Immortals-Robotics/ImmortalsMainPCB/README.md

# Immortals Main Electronics
The main electronics of Immortals SSL robots, used to receive commands from the main computer through wireless link, drive the robots’ motors, apply a control loop on the motors, do some local sensing and send some feedback data to the main computer.
