Immortals-Robotics/ImmortalsMainPCB/compute-module.kicad_sch

## KiCad design compute-module.kicad_sch (2024-02-27)

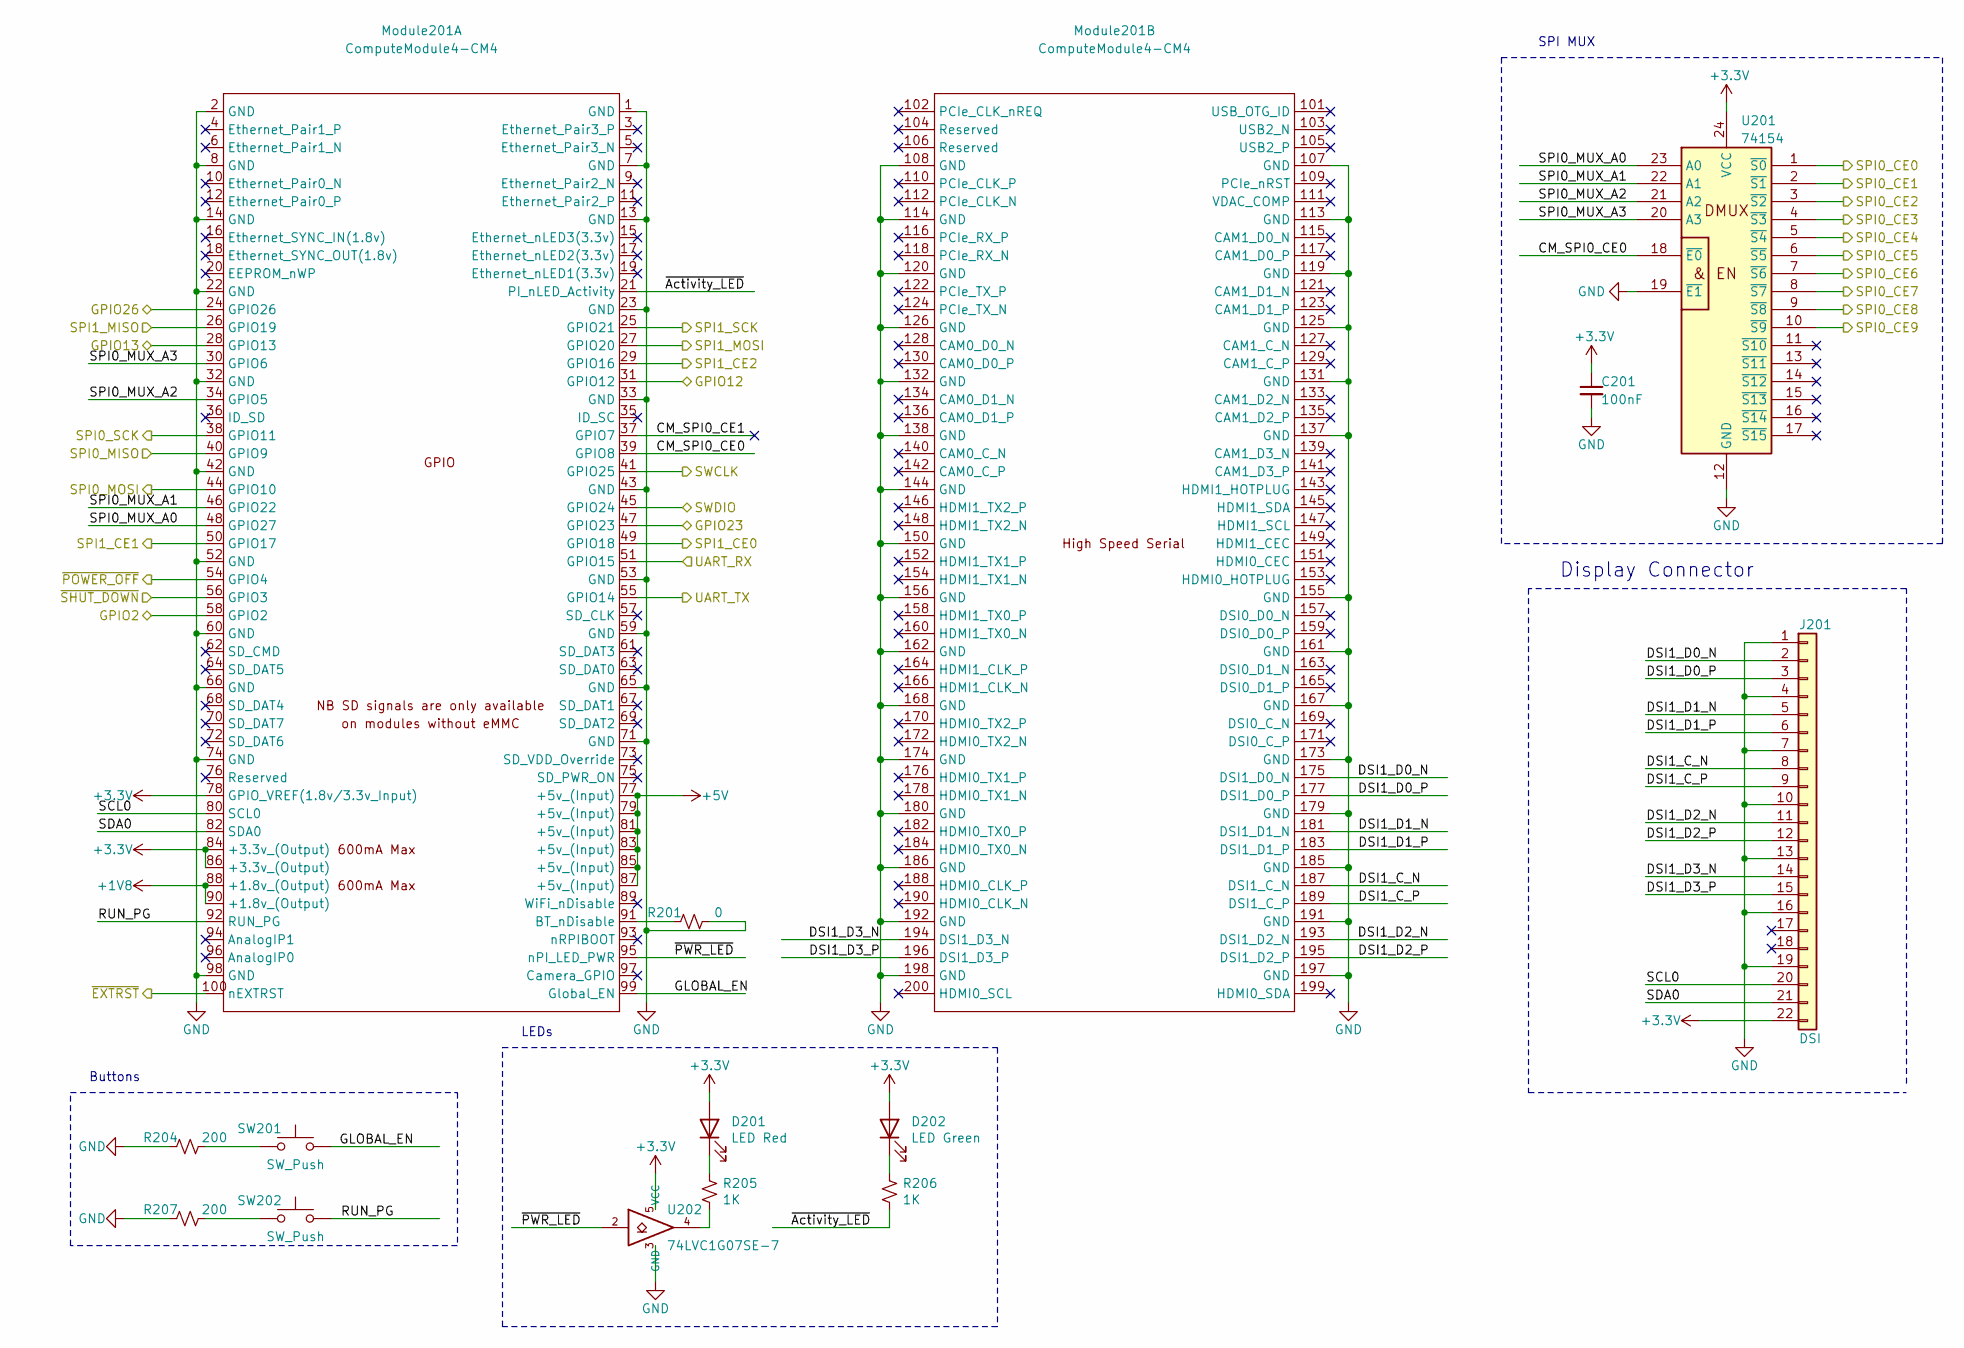
[picture p1: schematic compute-module.kicad_sch]

Parts:
C201: 100nF; C_0603_1608Metric; MPN C0603C104K4RAC7081
D201: LED Red; LED_0603_1608Metric; MPN B1911USD-20D000114U1930
D202: LED Green; LED_0603_1608Metric; MPN B1911PG--20D000514U1930
J201: DSI; Hirose_FH12-22S-0.5SH_1x22-1MP_P0.50mm_Horizontal; MPN FH12-22S-0.5SH55
Module201: ComputeModule4-CM4; rpi-cm4; MPN 2x DF40C-100DS-0.4V(51)
R201: 0; R_0603_1608Metric; MPN RMCF0603ZT0R00
R204, R207: 200; R_0603_1608Metric; MPN RC0603FR-13200RL
R205, R206: 1K; R_0603_1608Metric; MPN RC0603FR-101KL
SW201, SW202: SW_Push; SW_SPST_B3U-1000P; MPN B3U-1000P
U201: 74154; DHVQFN24; MPN 74HCT154BQ,118
U202: 74LVC1G07SE-7; SOT-353_SC-70-5; MPN 74LVC1G07SE-7

Connections:
+1V8: Module201.88 (+1.8v_(Output)), Module201.90 (+1.8v_(Output))
+3.3V: C201.1, D201.2 (A), D202.2 (A), J201.22, Module201.78 (GPIO_VREF(1.8v/3.3v_Input)), Module201.84 (+3.3v_(Output)), Module201.86 (+3.3v_(Output)), U201.24 (VCC), U202.5 (VCC)
+5V: Module201.77 (+5v_(Input)), Module201.79 (+5v_(Input)), Module201.81 (+5v_(Input)), Module201.83 (+5v_(Input)), Module201.85 (+5v_(Input)), Module201.87 (+5v_(Input))
CM_SPI0_CE0: Module201.39 (GPIO8), U201.18 (~E0)
CM_SPI0_CE1: Module201.37 (GPIO7)
DSI1_C_N: J201.8, Module201.187 (DSI1_C_N)
DSI1_C_P: J201.9, Module201.189 (DSI1_C_P)
DSI1_D0_N: J201.2, Module201.175 (DSI1_D0_N)
DSI1_D0_P: J201.3, Module201.177 (DSI1_D0_P)
DSI1_D1_N: J201.5, Module201.181 (DSI1_D1_N)
DSI1_D1_P: J201.6, Module201.183 (DSI1_D1_P)
DSI1_D2_N: J201.11, Module201.193 (DSI1_D2_N)
DSI1_D2_P: J201.12, Module201.195 (DSI1_D2_P)
GLOBAL_EN: Module201.99 (Global_EN), SW201.2
GND: C201.2, J201.1, J201.4, J201.7, J201.10, J201.13, J201.14, J201.15, J201.16, J201.19, Module201.1 (GND), Module201.2 (GND), Module201.7 (GND), Module201.8 (GND), Module201.13 (GND), Module201.14 (GND), Module201.22 (GND), Module201.23 (GND), Module201.32 (GND), Module201.33 (GND), Module201.42 (GND), Module201.43 (GND), Module201.52 (GND), Module201.53 (GND), Module201.59 (GND), Module201.60 (GND), Module201.65 (GND), Module201.66 (GND), Module201.71 (GND), Module201.74 (GND), Module201.98 (GND), Module201.107 (GND), Module201.108 (GND), Module201.113 (GND), Module201.114 (GND), Module201.119 (GND), Module201.120 (GND), Module201.125 (GND), Module201.126 (GND), Module201.131 (GND), Module201.132 (GND), Module201.137 (GND), Module201.138 (GND), Module201.144 (GND), Module201.150 (GND), Module201.155 (GND), Module201.156 (GND), Module201.161 (GND), Module201.162 (GND), Module201.167 (GND), Module201.168 (GND), Module201.173 (GND), Module201.174 (GND), Module201.179 (GND), Module201.180 (GND), Module201.185 (GND), Module201.186 (GND), Module201.191 (GND), Module201.192 (GND), Module201.194 (DSI1_D3_N), Module201.196 (DSI1_D3_P), Module201.197 (GND), Module201.198 (GND), R201.2, R204.1, R207.1, U201.12 (GND), U201.19 (~E1), U202.3 (GND)
GPIO2: Module201.58 (GPIO2)
GPIO12: Module201.31 (GPIO12)
GPIO13: Module201.28 (GPIO13)
GPIO23: Module201.47 (GPIO23)
GPIO26: Module201.24 (GPIO26)
unnamed: D201.1 (K), R205.1
unnamed: D202.1 (K), R206.1
unnamed: Module201.91 (BT_nDisable), R201.1
unnamed: R204.2, SW201.1
unnamed: R205.2, U202.4
unnamed: R207.2, SW202.1
RUN_PG: Module201.92 (RUN_PG), SW202.2
SCL0: J201.20, Module201.80 (SCL0)
SDA0: J201.21, Module201.82 (SDA0)
SPI0_CE0: U201.1 (~S0)
SPI0_CE1: U201.2 (~S1)
SPI0_CE2: U201.3 (~S2)
SPI0_CE3: U201.4 (~S3)
SPI0_CE4: U201.5 (~S4)
SPI0_CE5: U201.6 (~S5)
SPI0_CE6: U201.7 (~S6)
SPI0_CE7: U201.8 (~S7)
SPI0_CE8: U201.9 (~S8)
SPI0_CE9: U201.10 (~S9)
SPI0_MISO: Module201.40 (GPIO9)
SPI0_MOSI: Module201.44 (GPIO10)
SPI0_MUX_A0: Module201.48 (GPIO27), U201.23 (A0)
SPI0_MUX_A1: Module201.46 (GPIO22), U201.22 (A1)
SPI0_MUX_A2: Module201.34 (GPIO5), U201.21 (A2)
SPI0_MUX_A3: Module201.30 (GPIO6), U201.20 (A3)
SPI0_SCK: Module201.38 (GPIO11)
SPI1_CE0: Module201.49 (GPIO18)
SPI1_CE1: Module201.50 (GPIO17)
SPI1_CE2: Module201.29 (GPIO16)
SPI1_MISO: Module201.26 (GPIO19)
SPI1_MOSI: Module201.27 (GPIO20)
SPI1_SCK: Module201.25 (GPIO21)
SWCLK: Module201.41 (GPIO25)
SWDIO: Module201.45 (GPIO24)
UART_RX: Module201.51 (GPIO15)
UART_TX: Module201.55 (GPIO14)
~Activity_LED: Module201.21 (PI_nLED_Activity), R206.2
~EXTRST: Module201.100 (nEXTRST)
~POWER_OFF: Module201.54 (GPIO4)
~PWR_LED: Module201.95 (nPI_LED_PWR), U202.2
~SHUT_DOWN: Module201.56 (GPIO3)

Notes on the sheet:
Display Connector
SPI MUX
Buttons
LEDs
