Immortals-Robotics/ImmortalsMainPCB/main-board.kicad_sch

## KiCad design main-board.kicad_sch (2024-02-27)

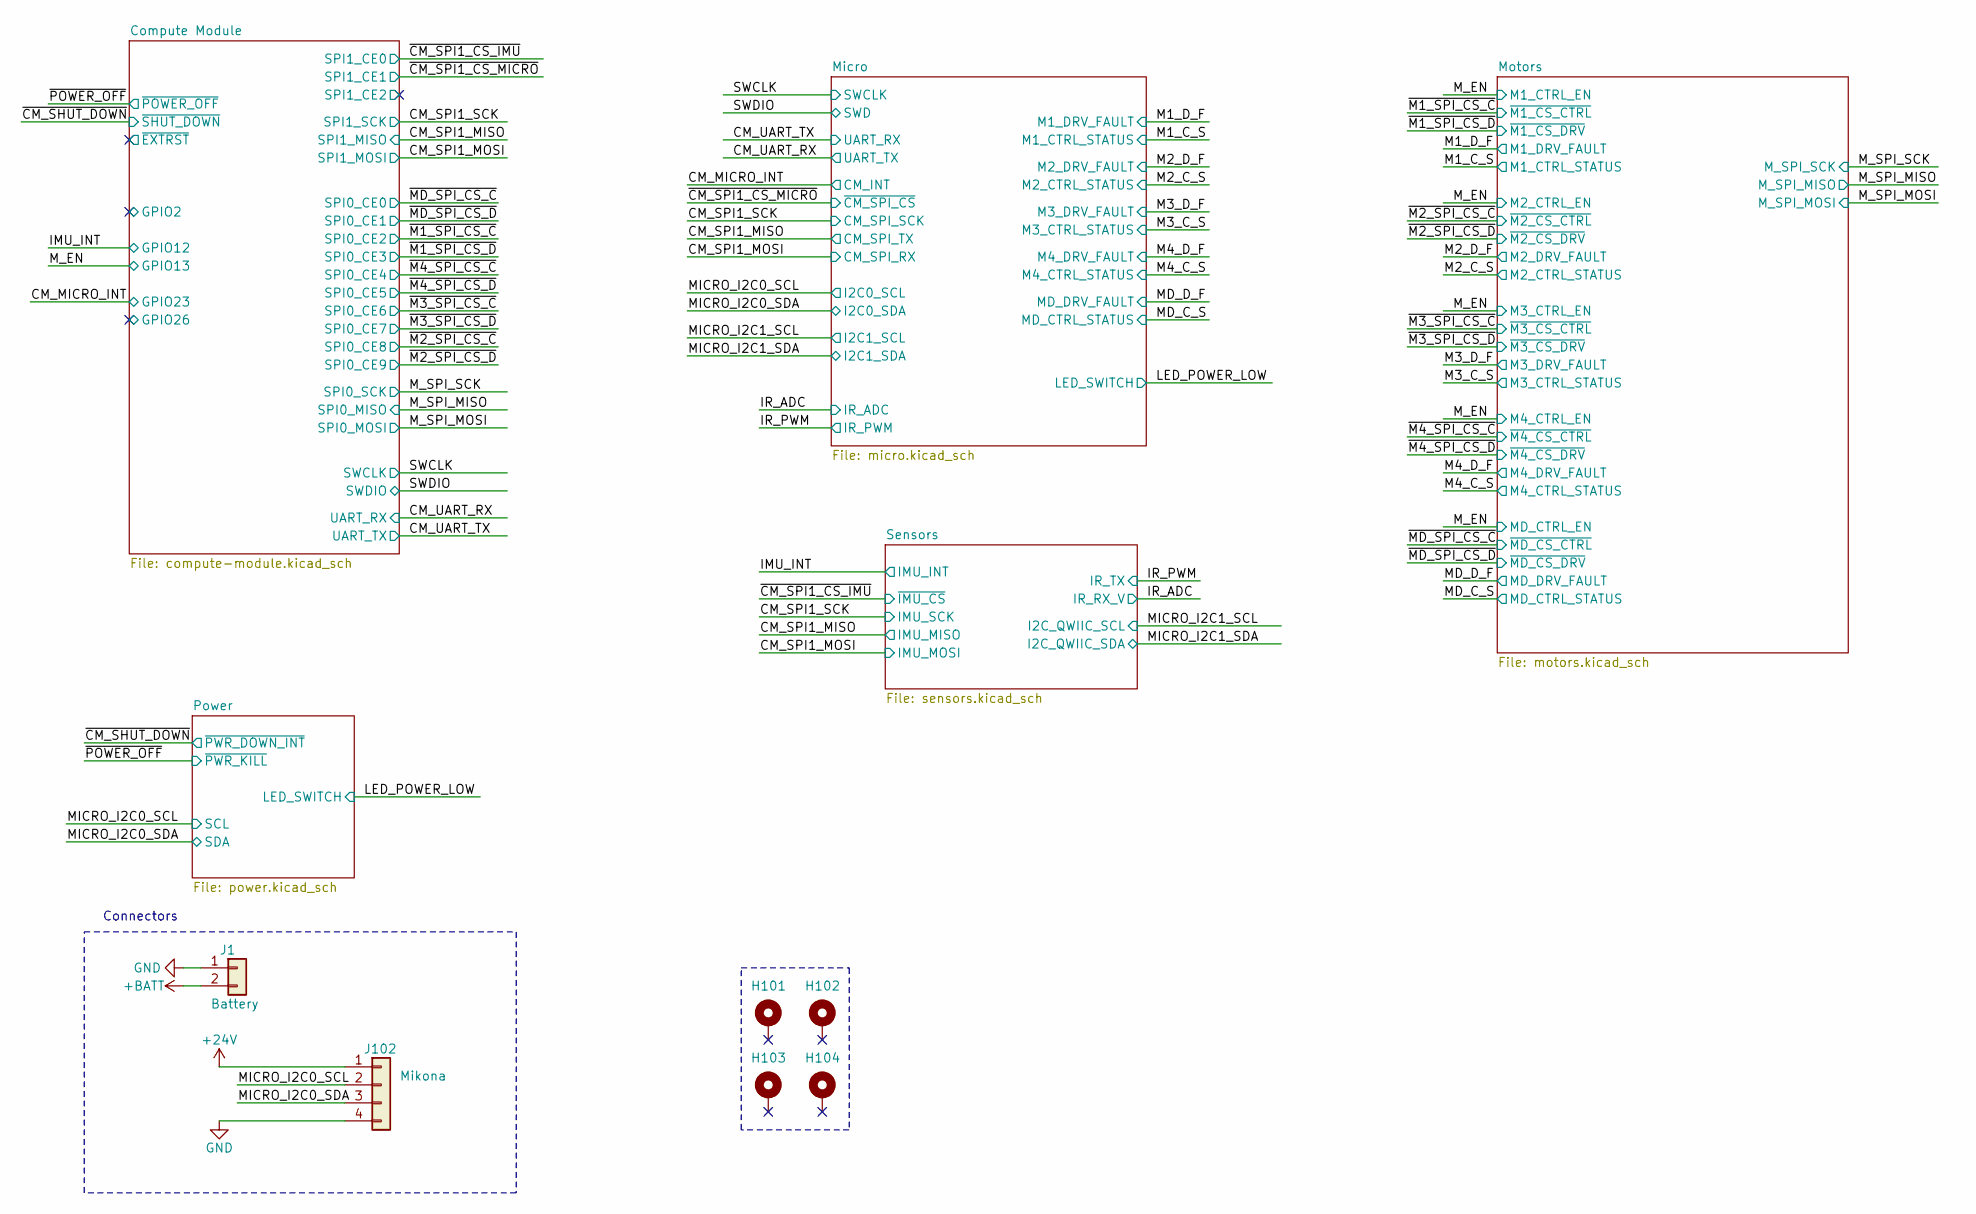
[picture p2: schematic main-board.kicad_sch]

Parts:
H101, H102, H103, H104: MountingHole_Pad; MountingHole_3.2mm_M3_ISO14580_Pad
J1: Battery; AMASS_XT60PW-M_1x02_P7.20mm_Horizontal; MPN XT60PW-M
J102: Mikona; MOLEX_1054301204; MPN 1054301204

Connections:
+24V: J102.1
+BATT: J1.2
GND: J1.1, J102.4
MICRO_I2C0_SCL: J102.2
MICRO_I2C0_SDA: J102.3

Notes on the sheet:
Connectors
