Immortals-Robotics/ImmortalsMainPCB/micro.kicad_sch

## KiCad design micro.kicad_sch (2024-02-27)

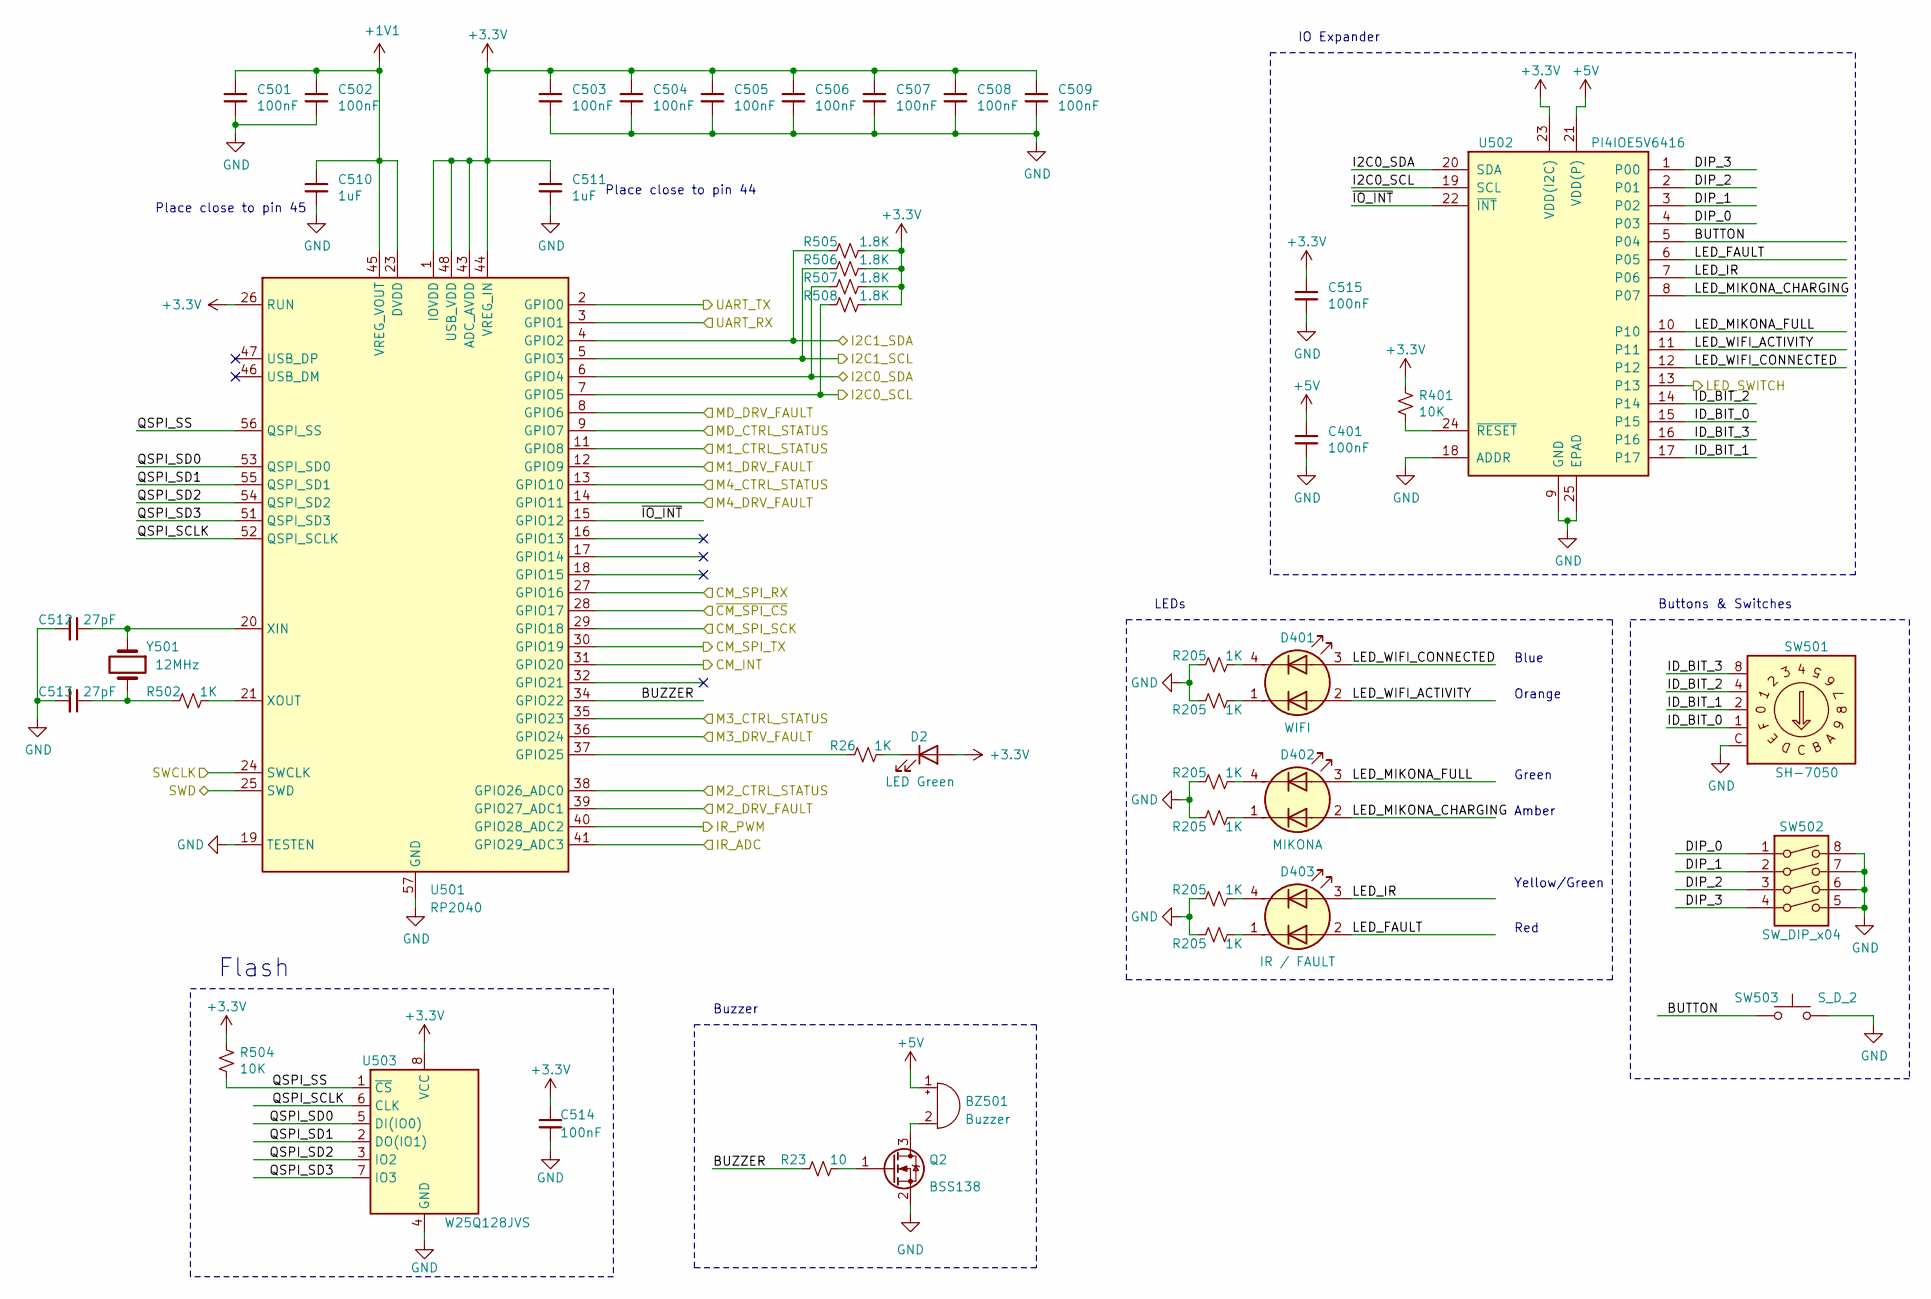
[picture p3: schematic micro.kicad_sch]

Parts:
BZ501: Buzzer; Indicator_PUI_AI-1440-TWT-24V-2-R; MPN CPI-137-83T
C401, C501, C502, C503, C504, C505, C506, C507, C508, C509, C514, C515: 100nF; C_0603_1608Metric; MPN C0603C104K4RAC7081
C510, C511: 1uF; C_0603_1608Metric; MPN C0603C105K4RAC7411
C512, C513: 27pF; C_0603_1608Metric; MPN 06035C270JAT2A
D2: LED Green; LED_0603_1608Metric; MPN B1911PG--20D000514U1930
D401: WIFI; B2612U; MPN B2612UDNB20D000312U1930
D402: MIKONA; B2612U; MPN B2612UYNG20D000412U1930
D403: IR / FAULT; B2612U; MPN B2612USUG20D000312U1930
Q2: BSS138; SOT-23; MPN BSS138-7-F
R23: 10; R_0603_1608Metric; MPN RC0603FR-1010RL
R26, R205, R502: 1K; R_0603_1608Metric; MPN RC0603FR-101KL
R401, R504: 10K; R_0603_1608Metric; MPN RC0603JR-1010KL
R505, R506, R507, R508: 1.8K; R_0603_1608Metric; MPN RC0603FR-101K8L
SW501: SH-7050; Nidec_Copal_SH-7010A; MPN SH-7050TA
SW502: SW_DIP_x04; SW_DIP_SPSTx04_Slide_6.7x11.72mm_W8.61mm_P2.54mm_LowProfile; MPN 219-4MST
SW503: S_D_2; SW_Push_1P1T_NO_6x6mm_H9.5mm; MPN PTS645SL43SMTR92 LFS
U501: RP2040; QFN-56-1EP_7x7mm_P0.4mm_EP3.2x3.2mm; MPN SC0914(13)
U502: PI4IOE5V6416; WQFN-24-1EP_4x4mm_P0.5mm_EP2.45x2.45mm; MPN PI4IOE5V6416ZDEX
U503: W25Q128JVS; SOIC-8_5.23x5.23mm_P1.27mm; MPN W25Q128JVSIQ
Y501: 12MHz; Crystal_SMD_5032-2Pin_5.0x3.2mm; MPN 445C25D12M00000

Connections:
+1V1: C501.1, C502.1, C510.1, U501.23 (DVDD), U501.45 (VREG_VOUT), U501.50 (DVDD)
+3.3V: C503.1, C504.1, C505.1, C506.1, C507.1, C508.1, C509.1, C511.1, C514.1, C515.1, D2.2 (A), R401.1, R504.1, R505.1, R506.1, R507.1, R508.1, U501.1 (IOVDD), U501.10 (IOVDD), U501.22 (IOVDD), U501.26 (RUN), U501.33 (IOVDD), U501.42 (IOVDD), U501.43 (ADC_AVDD), U501.44 (VREG_IN), U501.48 (USB_VDD), U501.49 (IOVDD), U502.23 (VDD(I2C)), U503.8 (VCC)
+5V: BZ501.1 (-), C401.1, U502.21 (VDD(P))
BUTTON: SW503.1, U502.5 (P04)
BUZZER: R23.1, U501.34 (GPIO22)
CM_INT: U501.31 (GPIO20)
CM_SPI_RX: U501.27 (GPIO16)
CM_SPI_SCK: U501.29 (GPIO18)
CM_SPI_TX: U501.30 (GPIO19)
DIP_0: SW502.1, U502.4 (P03)
DIP_1: SW502.2, U502.3 (P02)
DIP_2: SW502.3, U502.2 (P01)
DIP_3: SW502.4, U502.1 (P00)
GND: C401.2, C501.2, C502.2, C503.2, C504.2, C505.2, C506.2, C507.2, C508.2, C509.2, C510.2, C511.2, C512.2, C513.2, C514.2, C515.2, Q2.2 (S), R205.1, SW501.C, SW502.5, SW502.6, SW502.7, SW502.8, SW503.2, U501.19 (TESTEN), U501.57 (GND), U502.9 (GND), U502.18 (ADDR), U502.25 (EPAD), U503.4 (GND)
I2C0_SCL: R508.2, U501.7 (GPIO5), U502.19 (SCL)
I2C0_SDA: R507.2, U501.6 (GPIO4), U502.20 (SDA)
I2C1_SCL: R506.2, U501.5 (GPIO3)
I2C1_SDA: R505.2, U501.4 (GPIO2)
ID_BIT_0: SW501.1, U502.15
ID_BIT_1: SW501.2, U502.17
ID_BIT_2: SW501.4, U502.14
ID_BIT_3: SW501.8, U502.16
IR_ADC: U501.41 (GPIO29_ADC3)
IR_PWM: U501.40 (GPIO28_ADC2)
LED_FAULT: D403.2 (A1), U502.6 (P05)
LED_IR: D403.3 (A2), U502.7 (P06)
LED_MIKONA_CHARGING: D402.2 (A1), U502.8 (P07)
LED_MIKONA_FULL: D402.3 (A2), U502.10
LED_SWITCH: U502.13
LED_WIFI_ACTIVITY: D401.2 (A1), U502.11
LED_WIFI_CONNECTED: D401.3 (A2), U502.12
M1_CTRL_STATUS: U501.11 (GPIO8)
M1_DRV_FAULT: U501.12 (GPIO9)
M2_CTRL_STATUS: U501.38 (GPIO26_ADC0)
M2_DRV_FAULT: U501.39 (GPIO27_ADC1)
M3_CTRL_STATUS: U501.35 (GPIO23)
M3_DRV_FAULT: U501.36 (GPIO24)
M4_CTRL_STATUS: U501.13 (GPIO10)
M4_DRV_FAULT: U501.14 (GPIO11)
MD_CTRL_STATUS: U501.9 (GPIO7)
MD_DRV_FAULT: U501.8 (GPIO6)
unnamed: BZ501.2 (+), Q2.3 (D)
unnamed: C512.1, U501.20 (XIN), Y501.1
unnamed: C513.1, R502.2, Y501.2
unnamed: D2.1 (K), R26.2
unnamed: D401.1 (K1), R205.2
unnamed: D401.4 (K2), R205.2
unnamed: D402.1 (K1), R205.2
unnamed: D402.4 (K2), R205.2
unnamed: D403.1 (K1), R205.2
unnamed: D403.4 (K2), R205.2
unnamed: Q2.1 (G), R23.2
unnamed: R26.1, U501.37 (GPIO25)
unnamed: R401.2, U502.24 (~RESET)
unnamed: R502.1, U501.21 (XOUT)
QSPI_SCLK: U501.52 (QSPI_SCLK), U503.6 (CLK)
QSPI_SD0: U501.53 (QSPI_SD0), U503.5 (DI(IO0))
QSPI_SD1: U501.55 (QSPI_SD1), U503.2 (DO(IO1))
QSPI_SD2: U501.54 (QSPI_SD2), U503.3 (IO2)
QSPI_SD3: U501.51 (QSPI_SD3), U503.7 (IO3)
QSPI_SS: R504.2, U501.56 (QSPI_SS), U503.1 (~CS)
SWCLK: U501.24 (SWCLK)
SWD: U501.25 (SWD)
UART_RX: U501.3 (GPIO1)
UART_TX: U501.2 (GPIO0)
~CM_SPI_CS: U501.28 (GPIO17)
~IO_INT: U501.15 (GPIO12), U502.22 (~INT)

Notes on the sheet:
Place close to pin 44
Flash
Place close to pin 45
Red
LEDs
Orange
IO Expander
Green
Buttons & Switches
Amber
Buzzer
Yellow/Green
Blue
