Immortals-Robotics/ImmortalsMainPCB/motors.kicad_sch

## KiCad design motors.kicad_sch (2024-02-27)

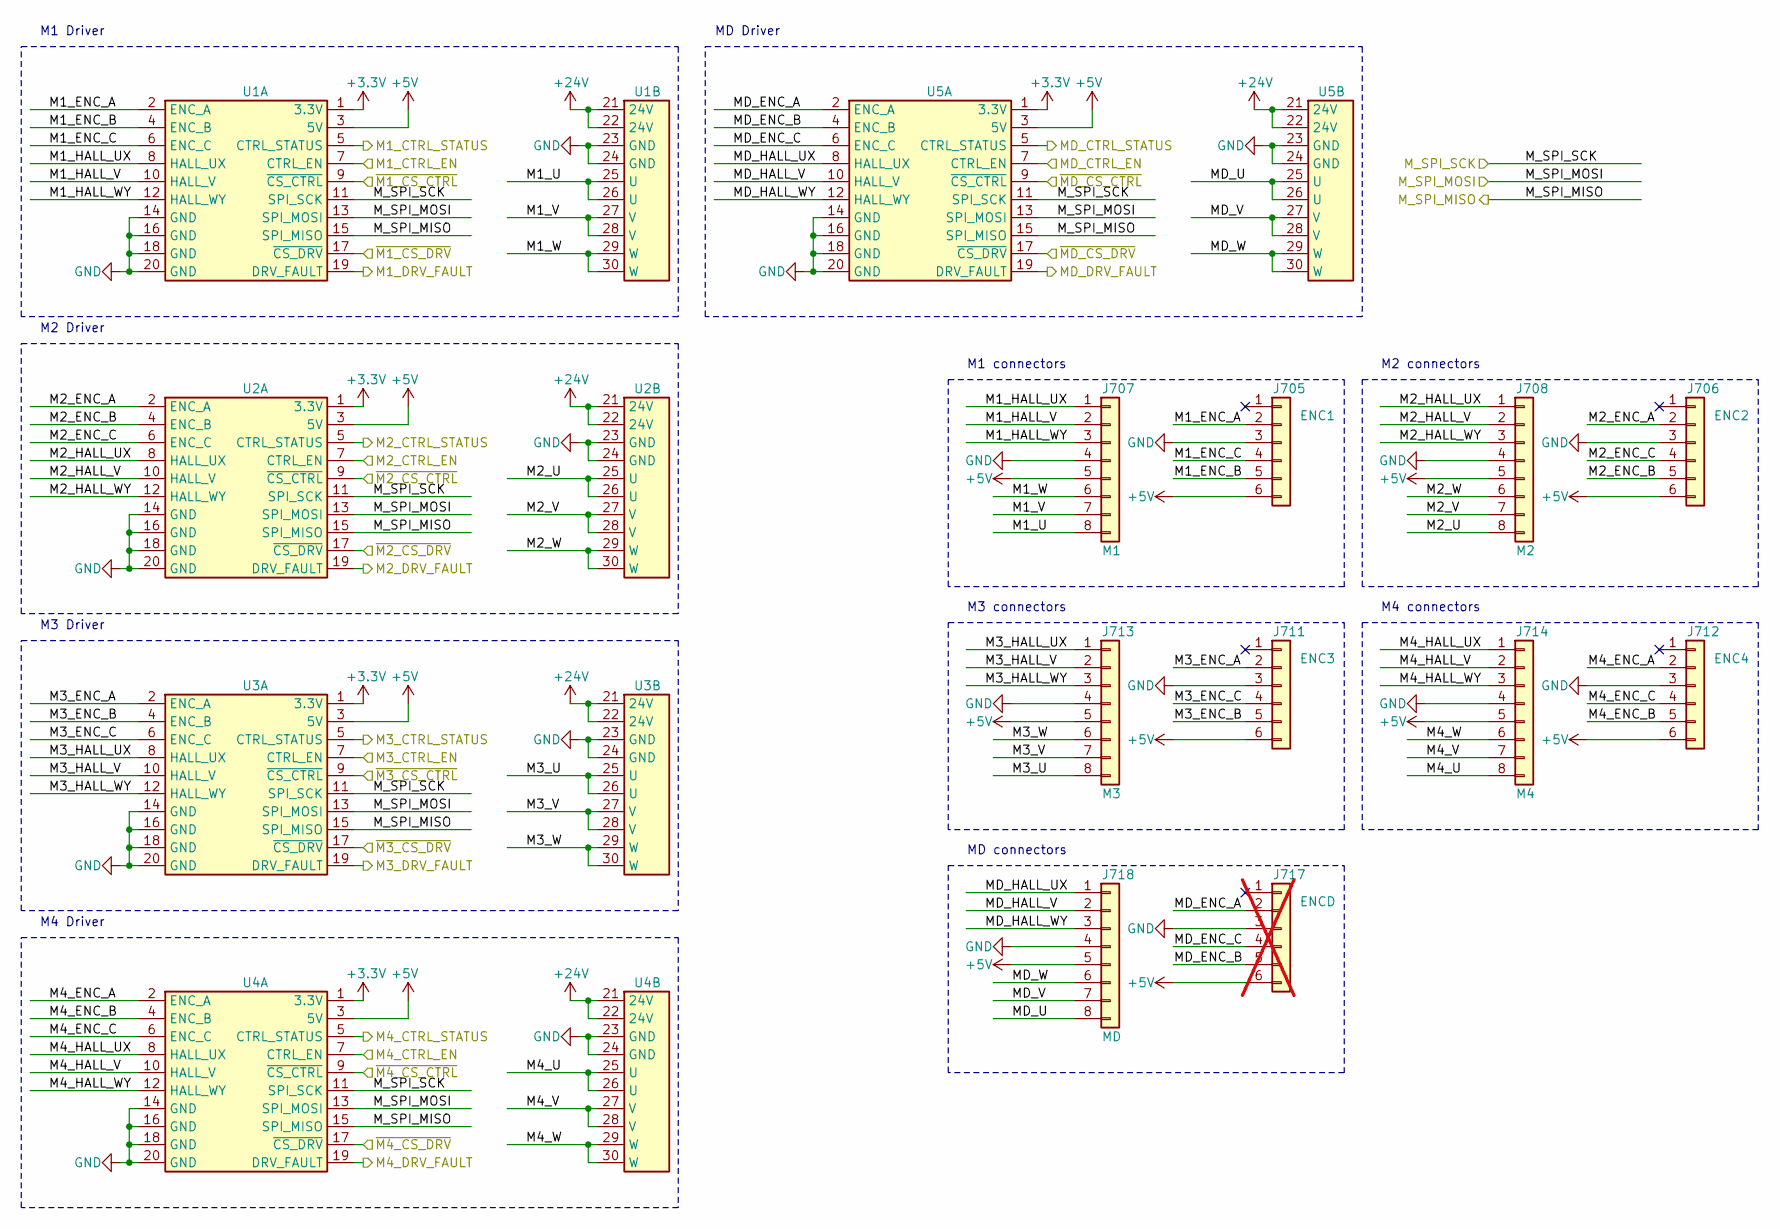
[picture p4: schematic motors.kicad_sch]

Parts:
J705: ENC1; Molex_PicoBlade_53261-0671_1x06-1MP_P1.25mm_Horizontal; MPN 0532610671
J706: ENC2; Molex_PicoBlade_53261-0671_1x06-1MP_P1.25mm_Horizontal; MPN 0532610671
J707: M1; JST_XH_S8B-XH-A_1x08_P2.50mm_Horizontal; MPN S8B-XH-A(LF)(SN)
J708: M2; JST_XH_S8B-XH-A_1x08_P2.50mm_Horizontal; MPN S8B-XH-A(LF)(SN)
J711: ENC3; Molex_PicoBlade_53261-0671_1x06-1MP_P1.25mm_Horizontal; MPN 0532610671
J712: ENC4; Molex_PicoBlade_53261-0671_1x06-1MP_P1.25mm_Horizontal; MPN 0532610671
J713: M3; JST_XH_S8B-XH-A_1x08_P2.50mm_Horizontal; MPN S8B-XH-A(LF)(SN)
J714: M4; JST_XH_S8B-XH-A_1x08_P2.50mm_Horizontal; MPN S8B-XH-A(LF)(SN)
J717: ENCD; Molex_PicoBlade_53261-0671_1x06-1MP_P1.25mm_Horizontal; MPN 0532610671; not fitted
J718: MD; JST_XH_S8B-XH-A_1x08_P2.50mm_Horizontal; MPN S8B-XH-A(LF)(SN)
U1, U2, U3, U4, U5: MotorDriver-SMT; MPN 61032021821 + NPPC101KFXC-RC

Connections:
+3.3V: U1.1 (3.3V), U2.1 (3.3V), U3.1 (3.3V), U4.1 (3.3V), U5.1 (3.3V)
+5V: J705.6, J706.6, J707.5, J708.5, J711.6, J712.6, J713.5, J714.5, J717.6, J718.5, U1.3 (5V), U2.3 (5V), U3.3 (5V), U4.3 (5V), U5.3 (5V)
+24V: U1.21 (24V), U1.22 (24V), U2.21 (24V), U2.22 (24V), U3.21 (24V), U3.22 (24V), U4.21 (24V), U4.22 (24V), U5.21 (24V), U5.22 (24V)
GND: J705.3, J706.3, J707.4, J708.4, J711.3, J712.3, J713.4, J714.4, J717.3, J718.4, U1.14 (GND), U1.16 (GND), U1.18 (GND), U1.20 (GND), U1.23 (GND), U1.24 (GND), U2.14 (GND), U2.16 (GND), U2.18 (GND), U2.20 (GND), U2.23 (GND), U2.24 (GND), U3.14 (GND), U3.16 (GND), U3.18 (GND), U3.20 (GND), U3.23 (GND), U3.24 (GND), U4.14 (GND), U4.16 (GND), U4.18 (GND), U4.20 (GND), U4.23 (GND), U4.24 (GND), U5.14 (GND), U5.16 (GND), U5.18 (GND), U5.20 (GND), U5.23 (GND), U5.24 (GND)
M1_CTRL_EN: U1.7 (CTRL_EN)
M1_CTRL_STATUS: U1.5 (CTRL_STATUS)
M1_DRV_FAULT: U1.19 (DRV_FAULT)
M1_ENC_A: J705.2, U1.2 (ENC_A)
M1_ENC_B: J705.5, U1.4 (ENC_B)
M1_ENC_C: J705.4, U1.6 (ENC_C)
M1_HALL_UX: J707.1, U1.8 (HALL_UX)
M1_HALL_V: J707.2, U1.10 (HALL_V)
M1_HALL_WY: J707.3, U1.12 (HALL_WY)
M1_U: J707.8, U1.25 (U), U1.26 (U)
M1_V: J707.7, U1.27 (V), U1.28 (V)
M1_W: J707.6, U1.29 (W), U1.30 (W)
M2_CTRL_EN: U2.7 (CTRL_EN)
M2_CTRL_STATUS: U2.5 (CTRL_STATUS)
M2_DRV_FAULT: U2.19 (DRV_FAULT)
M2_ENC_A: J706.2, U2.2 (ENC_A)
M2_ENC_B: J706.5, U2.4 (ENC_B)
M2_ENC_C: J706.4, U2.6 (ENC_C)
M2_HALL_UX: J708.1, U2.8 (HALL_UX)
M2_HALL_V: J708.2, U2.10 (HALL_V)
M2_HALL_WY: J708.3, U2.12 (HALL_WY)
M2_U: J708.8, U2.25 (U), U2.26 (U)
M2_V: J708.7, U2.27 (V), U2.28 (V)
M2_W: J708.6, U2.29 (W), U2.30 (W)
M3_CTRL_EN: U3.7 (CTRL_EN)
M3_CTRL_STATUS: U3.5 (CTRL_STATUS)
M3_DRV_FAULT: U3.19 (DRV_FAULT)
M3_ENC_A: J711.2, U3.2 (ENC_A)
M3_ENC_B: J711.5, U3.4 (ENC_B)
M3_ENC_C: J711.4, U3.6 (ENC_C)
M3_HALL_UX: J713.1, U3.8 (HALL_UX)
M3_HALL_V: J713.2, U3.10 (HALL_V)
M3_HALL_WY: J713.3, U3.12 (HALL_WY)
M3_U: J713.8, U3.25 (U), U3.26 (U)
M3_V: J713.7, U3.27 (V), U3.28 (V)
M3_W: J713.6, U3.29 (W), U3.30 (W)
M4_CTRL_EN: U4.7 (CTRL_EN)
M4_CTRL_STATUS: U4.5 (CTRL_STATUS)
M4_DRV_FAULT: U4.19 (DRV_FAULT)
M4_ENC_A: J712.2, U4.2 (ENC_A)
M4_ENC_B: J712.5, U4.4 (ENC_B)
M4_ENC_C: J712.4, U4.6 (ENC_C)
M4_HALL_UX: J714.1, U4.8 (HALL_UX)
M4_HALL_V: J714.2, U4.10 (HALL_V)
M4_HALL_WY: J714.3, U4.12 (HALL_WY)
M4_U: J714.8, U4.25 (U), U4.26 (U)
M4_V: J714.7, U4.27 (V), U4.28 (V)
M4_W: J714.6, U4.29 (W), U4.30 (W)
MD_CTRL_EN: U5.7 (CTRL_EN)
MD_CTRL_STATUS: U5.5 (CTRL_STATUS)
MD_DRV_FAULT: U5.19 (DRV_FAULT)
MD_ENC_A: J717.2, U5.2 (ENC_A)
MD_ENC_B: J717.5, U5.4 (ENC_B)
MD_ENC_C: J717.4, U5.6 (ENC_C)
MD_HALL_UX: J718.1, U5.8 (HALL_UX)
MD_HALL_V: J718.2, U5.10 (HALL_V)
MD_HALL_WY: J718.3, U5.12 (HALL_WY)
MD_U: J718.8, U5.25 (U), U5.26 (U)
MD_V: J718.7, U5.27 (V), U5.28 (V)
MD_W: J718.6, U5.29 (W), U5.30 (W)
M_SPI_MISO: U1.15 (SPI_MISO), U2.15 (SPI_MISO), U3.15 (SPI_MISO), U4.15 (SPI_MISO), U5.15 (SPI_MISO)
M_SPI_MOSI: U1.13 (SPI_MOSI), U2.13 (SPI_MOSI), U3.13 (SPI_MOSI), U4.13 (SPI_MOSI), U5.13 (SPI_MOSI)
M_SPI_SCK: U1.11 (SPI_SCK), U2.11 (SPI_SCK), U3.11 (SPI_SCK), U4.11 (SPI_SCK), U5.11 (SPI_SCK)
~M1_CS_CTRL: U1.9 (~CS_CTRL)
~M1_CS_DRV: U1.17 (~CS_DRV)
~M2_CS_CTRL: U2.9 (~CS_CTRL)
~M2_CS_DRV: U2.17 (~CS_DRV)
~M3_CS_CTRL: U3.9 (~CS_CTRL)
~M3_CS_DRV: U3.17 (~CS_DRV)
~M4_CS_CTRL: U4.9 (~CS_CTRL)
~M4_CS_DRV: U4.17 (~CS_DRV)
~MD_CS_CTRL: U5.9 (~CS_CTRL)
~MD_CS_DRV: U5.17 (~CS_DRV)

Notes on the sheet:
MD connectors
M1 connectors
M3 connectors
M1 Driver
M4 Driver
M2 Driver
M2 connectors
MD Driver
M3 Driver
M4 connectors
