Immortals-Robotics/ImmortalsMainPCB/power.kicad_sch

## KiCad design power.kicad_sch (2024-02-27)

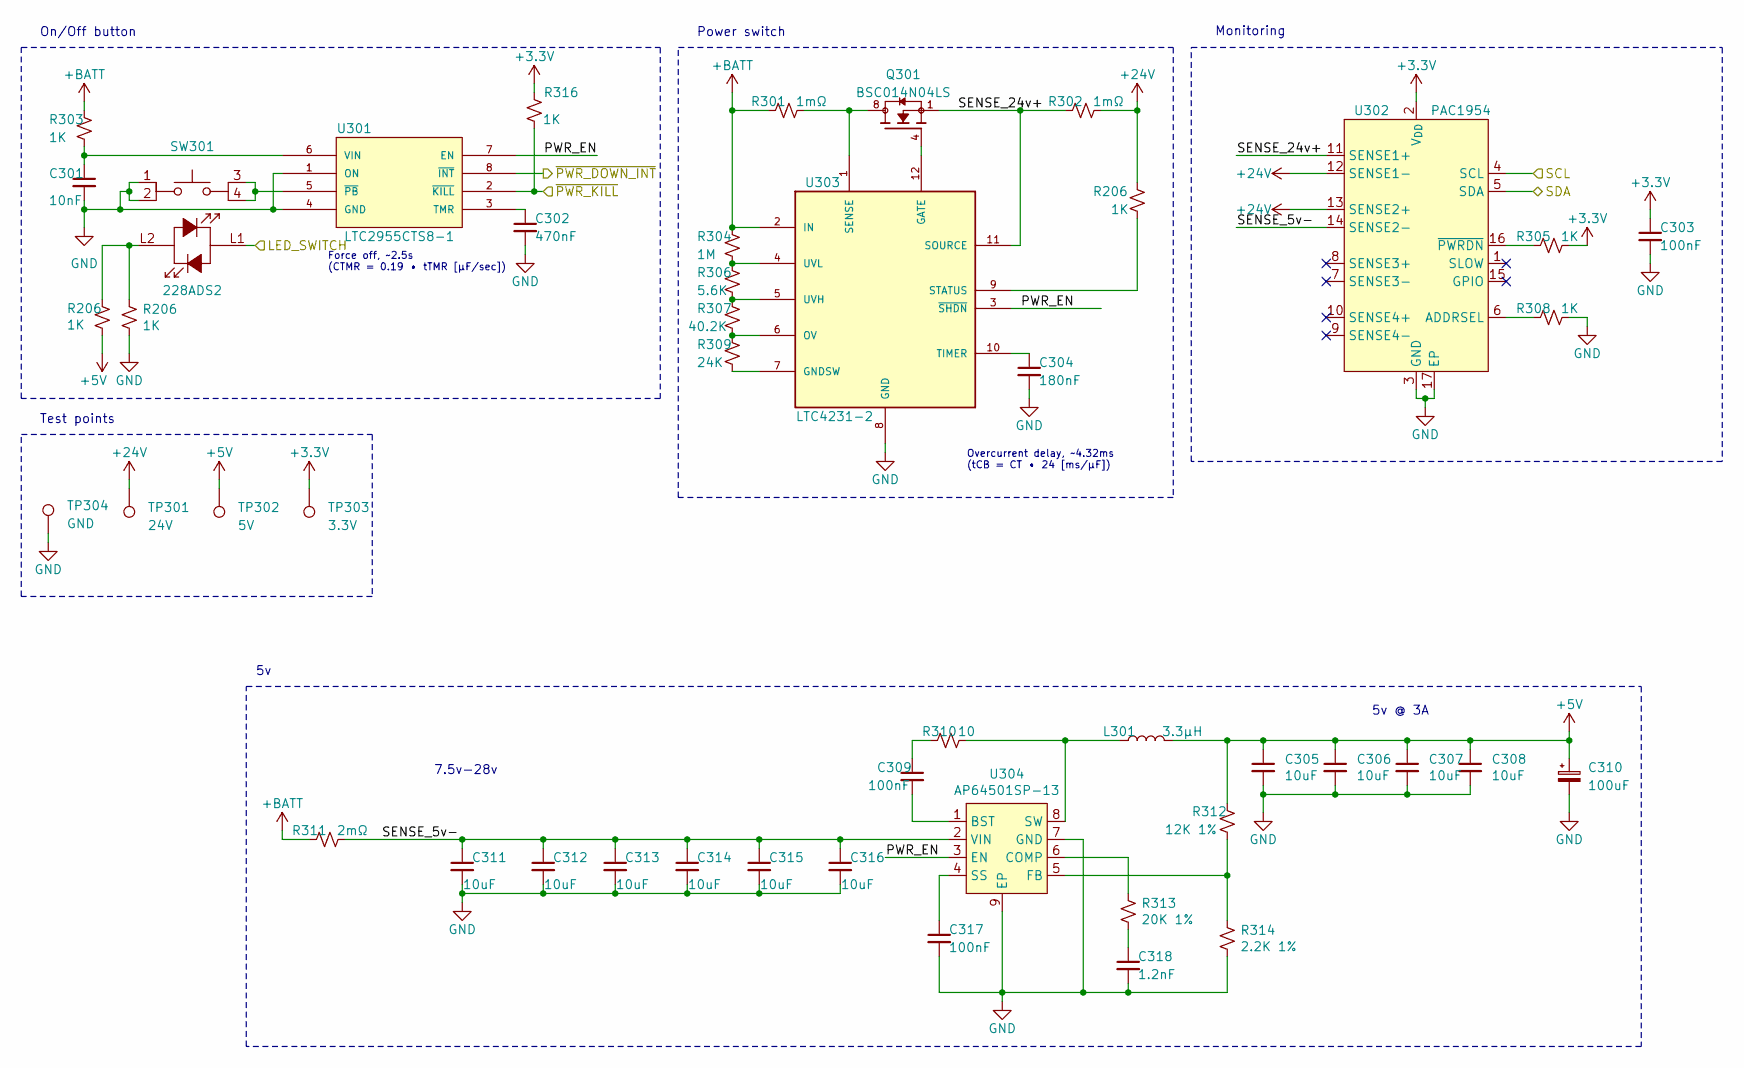
[picture p5: schematic power.kicad_sch]

Parts:
C301: 10nF; C_0805_2012Metric; MPN C0805C103K1RAC7025
C302: 470nF; C_0603_1608Metric; MPN GRM188R71E474KA12J
C303, C309, C317: 100nF; C_0603_1608Metric; MPN C0603C104K4RAC7081
C304: 180nF; C_0603_1608Metric; MPN GCM188R71E184KA55D
C305, C306, C307, C308, C311, C312, C313, C314, C315, C316: 10uF; C_0805_2012Metric; MPN GRM21BR61H106KE43L
C310: 100uF; CP_EIA-7343-31_Kemet-D; MPN T491D107K010AT
C318: 1.2nF; C_0603_1608Metric; MPN C0603C122K5RAC7867
L301: 3.3µH; L_Bourns_SRN6045TA; MPN SRN6045TA-3R3Y
Q301: BSC014N04LS; TRANS_BSC014N04LSIATMA1; MPN BSC014N04LSIATMA1
R206, R303, R305, R308, R316: 1K; R_0603_1608Metric; MPN RC0603FR-101KL
R301, R302: 1mΩ; R_2512_6332Metric; MPN EBWM2512F1L00S9
R304: 1M; R_0603_1608Metric; MPN RC0603DR-071ML
R306: 5.6K; R_0603_1608Metric; MPN RT0603DRE075K6L
R307: 40.2K; R_0603_1608Metric; MPN RT0603DRE0740K2L
R309: 24K; R_0603_1608Metric; MPN RT0603DRE0724KL
R310: 10; R_0603_1608Metric; MPN RC0603FR-1010RL
R311: 2mΩ; R_2512_6332Metric; MPN PEWF2512F2L00Q9
R312: 12K 1%; R_0603_1608Metric; MPN RC0603FR-1312KL
R313: 20K 1%; R_0603_1608Metric; MPN RC0603FR-0720KL
R314: 2.2K 1%; R_0603_1608Metric; MPN RC0603FR-132K2L
SW301: 228ADS2; MPN 228ADS2AAWFCMBA
TP301: 24V; TestPoint_Pad_D2.0mm
TP302: 5V; TestPoint_Pad_D2.0mm
TP303: 3.3V; TestPoint_Pad_D2.0mm
TP304: GND; TestPoint_Pad_D2.0mm
U301: LTC2955CTS8-1; TSOT-23-8; MPN LTC2955CTS8-1#TRMPBF
U302: PAC1954; VQFN-16-1EP_3x3mm_P0.5mm_EP1.1x1.1mm; MPN PAC1954T-E/4MX
U303: LTC4231-2; MSOP-12_3x4mm_P0.65mm; MPN LTC4231CMS-2#PBF
U304: AP64501SP-13; SOIC-8-1EP_3.9x4.9mm_P1.27mm_EP2.62x3.51mm; MPN AP64501SP-13

Connections:
+3.3V: C303.1, R305.1, R316.2, TP303.1, U302.2 (V_{DD})
+5V: C305.1, C306.1, C307.1, C308.1, C310.1, L301.2, R206.2, R312.1, TP302.1
+24V: R206.1, R302.1, TP301.1, U302.12 (SENSE1-), U302.13 (SENSE2+)
+BATT: R301.2, R303.1, R304.1, R311.2, U303.2 (IN)
GND: C301.2, C302.2, C303.2, C304.2, C305.2, C306.2, C307.2, C308.2, C310.2, C311.2, C312.2, C313.2, C314.2, C315.2, C316.2, C317.2, C318.2, R206.2, R308.1, R314.2, SW301.1, SW301.2, TP304.1, U301.1 (ON), U301.4 (GND), U302.3 (GND), U302.17 (EP), U303.8 (GND), U304.7 (GND), U304.9 (EP)
LED_SWITCH: SW301.L1
unnamed: C301.1, R303.2, U301.6 (VIN)
unnamed: C302.1, U301.3 (TMR)
unnamed: C304.1, U303.10 (TIMER)
unnamed: C309.1, R310.2
unnamed: C309.2, U304.1 (BST)
unnamed: C317.1, U304.4 (SS)
unnamed: C318.1, R313.2
unnamed: L301.1, R310.1, U304.8 (SW)
unnamed: Q301.4, U303.12 (GATE)
unnamed: Q301.8, R301.1, U303.1 (SENSE)
unnamed: R206.1, SW301.L2
unnamed: R206.2, U303.9 (STATUS)
unnamed: R304.2, R306.1, U303.4 (UVL)
unnamed: R305.2, U302.16 (~PWRDN)
unnamed: R306.2, R307.1, U303.5 (UVH)
unnamed: R307.2, R309.1, U303.6 (OV)
unnamed: R308.2, U302.6 (ADDRSEL)
unnamed: R309.2, U303.7 (GNDSW)
unnamed: R312.2, R314.1, U304.5 (FB)
unnamed: R313.1, U304.6 (COMP)
unnamed: SW301.3, SW301.4, U301.5 (~PB)
PWR_EN: U301.7 (EN), U303.3 (~SHDN), U304.3 (EN)
SCL: U302.4 (SCL)
SDA: U302.5 (SDA)
SENSE_5v-: C311.1, C312.1, C313.1, C314.1, C315.1, C316.1, R311.1, U302.14 (SENSE2-), U304.2 (VIN)
SENSE_24v+: Q301.1, R302.2, U302.11 (SENSE1+), U303.11 (SOURCE)
~PWR_DOWN_INT: U301.8 (~INT)
~PWR_KILL: R316.1, U301.2 (~KILL)

Notes on the sheet:
5v @ 3A
Force off, ~2.5s (CTMR = 0.19 • tTMR [µF/sec])
Test points
Monitoring
Overcurrent delay, ~4.32ms (tCB = CT • 24 [ms/µF])
Power switch
7.5v-28v
On/Off button
