Immortals-Robotics/ImmortalsMainPCB/sensors.kicad_sch

## KiCad design sensors.kicad_sch (2024-02-27)

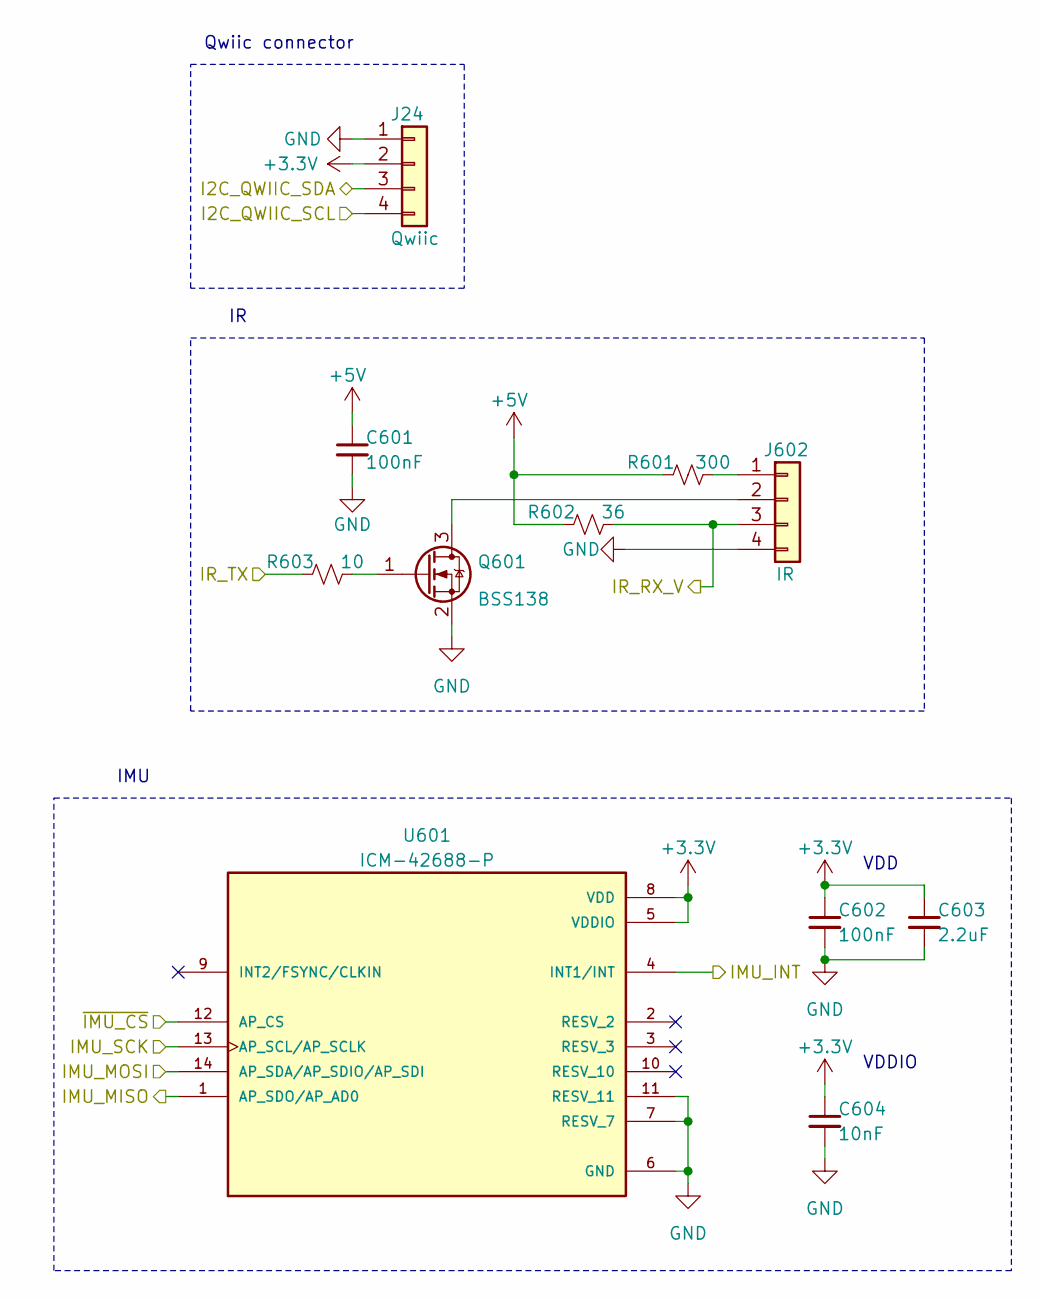
[picture p6: schematic sensors.kicad_sch]

Parts:
C601, C602: 100nF; C_0603_1608Metric; MPN C0603C104K4RAC7081
C603: 2.2uF; C_0805_2012Metric; MPN CC0805KKX7R9BB225
C604: 10nF; C_0603_1608Metric; MPN C0603C103M5RAC7411
J24: Qwiic; JST_SH_SM04B-SRSS-TB_1x04-1MP_P1.00mm_Horizontal; MPN SM04B-SRSS-TB(LF)(SN)
J602: IR; CONN_S4B-XH-SM4-TB_JST; MPN S4B-XH-SM4-TB(LF)(SN)
Q601: BSS138; SOT-23; MPN BSS138-7-F
R601: 300; R_0603_1608Metric; MPN RC0603JR-07300RL
R602: 36; R_0603_1608Metric; MPN RC0603FR-0736RL
R603: 10; R_0603_1608Metric; MPN RC0603FR-1010RL
U601: ICM-42688-P; PQFN50P300X250X97-14N; MPN ICM-42688-P

Connections:
+3.3V: C602.1, C603.1, C604.1, J24.2, U601.5 (VDDIO), U601.8 (VDD)
+5V: C601.1, R601.1, R602.1
GND: C601.2, C602.2, C603.2, C604.2, J24.1, J602.4, Q601.2 (S), U601.6 (GND), U601.7 (RESV_7), U601.11 (RESV_11)
I2C_QWIIC_SCL: J24.4
I2C_QWIIC_SDA: J24.3
IMU_INT: U601.4 (INT1/INT)
IMU_MISO: U601.1 (AP_SDO/AP_AD0)
IMU_MOSI: U601.14 (AP_SDA/AP_SDIO/AP_SDI)
IMU_SCK: U601.13 (AP_SCL/AP_SCLK)
IR_RX_V: J602.3, R602.2
IR_TX: R603.1
unnamed: J602.1, R601.2
unnamed: J602.2, Q601.3 (D)
unnamed: Q601.1 (G), R603.2
~IMU_CS: U601.12 (AP_CS)

Notes on the sheet:
Qwiic connector
VDD
VDDIO
IMU
