Immortals-Robotics/ImmortalsMainPCB/(commit log)

2016-05-02 Initial submission, finally found it :D
    [REV(5).PRJPCB, Rev(5).PCBDOC, Sheet1.SchDoc, bom.xls]
2016-06-01 Added pcb images
2023-05-06 Rev 2.0 of the main pcb, designed by Omid and Mrnik in 2018.
    [Dribbler.SchDoc, FPGA.SchDoc, ImmPCB2.PRJPCB, MCU.SchDoc, Motors&Drivers.SchDoc, NRF&Gyro.SchDoc, Power.SchDoc, REV(5).PRJPCB]
2023-05-07 Remove the old altium files and create the new kicad project.
    [Dribbler.SchDoc, FPGA.SchDoc, ImmPCB2.PRJPCB, MCU.SchDoc, Motors&Drivers.SchDoc, NRF&Gyro.SchDoc, Power.SchDoc, Switches.SchDoc]
2023-05-10 Doing schematics, almost done.
    [ball-detection.kicad_sch, can.kicad_sch, cm4-gpio.kicad_sch, cm4-high-speed.kicad_sch, compute-module.kicad_sch, imu.kicad_sch, main-board.kicad_sch, power.kicad_sch]
2023-05-10 Allocate GPIOs.
    [cm4-gpio.kicad_sch, main-board.kicad_sch, motors.kicad_sch]
2023-05-10 Finish motor schematics.
    [main-board.kicad_sch, motors.kicad_sch]
2023-05-10 Move sensors to one sheet.
    [ball-detection.kicad_sch, imu.kicad_sch, main-board.kicad_sch, rfid.kicad_sch, sensors.kicad_sch]
2023-05-10 Unify CM4 sub-sheets.
    [cm4-gpio.kicad_sch, cm4-high-speed.kicad_sch, compute-module.kicad_sch, main-board.kicad_sch]
2023-05-10 Add RP2040
    [compute-module.kicad_sch, main-board.kicad_sch, micro.kicad_sch, power.kicad_sch, sensors.kicad_sch]
2023-05-14 Finish RP2040 connections.
    [main-board.kicad_sch, micro.kicad_sch, sensors.kicad_sch]
2023-05-15 Finish connecting everything in sch.
    [can.kicad_sch, compute-module.kicad_sch, main-board.kicad_sch, micro.kicad_sch, power.kicad_sch, sensors.kicad_sch]
2023-05-15 Fix sch errors and warnings.
    [compute-module.kicad_sch, main-board.kicad_sch, micro.kicad_sch, motors.kicad_sch, power.kicad_sch]
2023-05-15 Assign some of the footprints and MPNs.
    [can.kicad_sch, compute-module.kicad_sch, micro.kicad_sch, motors.kicad_sch, power.kicad_sch, sensors.kicad_sch]
2023-05-17 Import the previous main board to match the overall shape, and re-annotate the schematic.
    [can.kicad_sch, compute-module.kicad_sch, main-board.kicad_pcb, main-board.kicad_sch, micro.kicad_sch, motors.kicad_sch, power.kicad_sch, sensors.kicad_sch]
2023-05-17 Start placing parts on pcb.
    [compute-module.kicad_sch, main-board.kicad_pcb, motors.kicad_sch]
2023-05-18 Place all the components on the PCB.
    [main-board.kicad_pcb, main-board.kicad_sch, motors.kicad_sch, sensors.kicad_sch]
2023-05-21 Finish the draft routing.
    [can.kicad_sch, compute-module.kicad_sch, main-board.kicad_pcb, main-board.kicad_sch, micro.kicad_sch, motors.kicad_sch, power.kicad_sch, sensors.kicad_sch]
2023-05-21 Fix motor winding order.
    [main-board.kicad_pcb, motors.kicad_sch]
2023-05-21 Improve routings,
    [main-board.kicad_pcb, micro.kicad_sch, motors.kicad_sch, power.kicad_sch]
2023-05-22 Improve routings.
    [main-board.kicad_pcb, power.kicad_sch]
2023-05-22 Fixed silkscreen and added teardrops.
2023-05-22 Update MPNs.
    [compute-module.kicad_sch, micro.kicad_sch, motors.kicad_sch, power.kicad_sch, sensors.kicad_sch]
2023-05-29 Add MPNs for CM4 and motor drivers.
    [compute-module.kicad_sch, motors.kicad_sch]
2023-05-29 Update MPNs in the PCB as well.
2023-06-05 Fix the issues found during testing in schematics.
    [compute-module.kicad_sch, main-board.kicad_sch, micro.kicad_sch, motors.kicad_sch, power.kicad_sch, sensors.kicad_sch]
2023-06-05 Applied the fixes to the PCB as well.
    [compute-module.kicad_sch, micro.kicad_sch, motors.kicad_sch, power.kicad_sch]
2023-06-05 More refinements to the PCB.
    [power.kicad_sch]
2023-06-09 Use parts similar to other boards where possible.
    [compute-module.kicad_sch, motors.kicad_sch, power.kicad_sch, sensors.kicad_sch]
2023-06-09 Change on-board LEDs to vertical diffuse.
    [compute-module.kicad_sch, micro.kicad_sch]
2023-06-11 Fix the 24v sense res and the IR port MPN.
    [power.kicad_sch, sensors.kicad_sch]
